TECHNOTICSROBOTICS/avr-nrf/hardware/avr-nrf.brd

## EAGLE design hardware/avr-nrf.brd (2012-05-06)

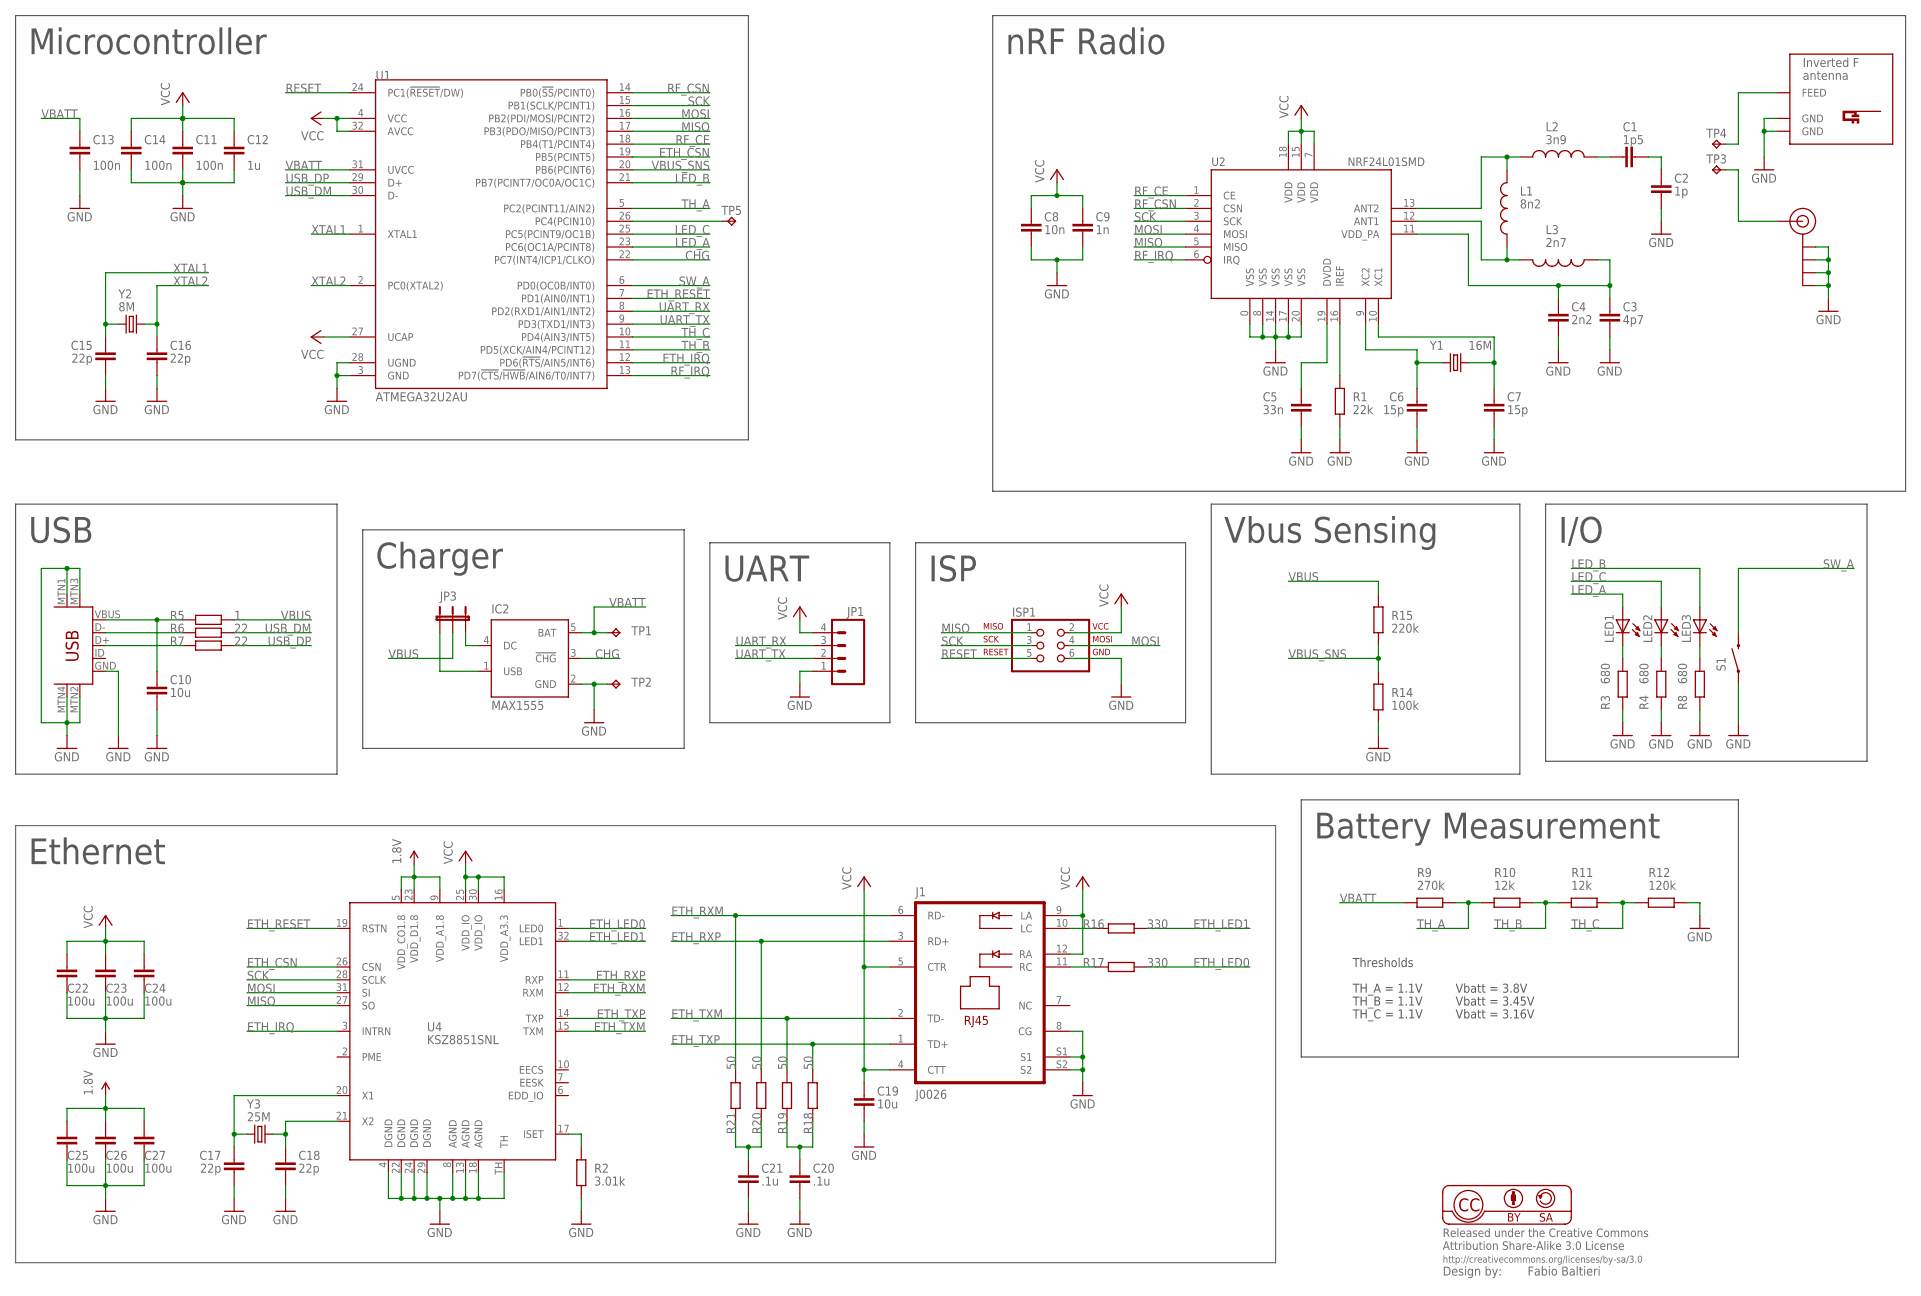
[picture p1: schematic avr-nrf.sch]

Parts:
C1: 1p5; C0805
C2: 1p; C0805
C3: 4p7; C0805
C4: 2n2; C0805
C5: 33n; C0805
C6, C7: 15p; C0805
C8: 10n; C0805
C9: 1n; C0805
C10, C19: 10u; C0805
C11, C13, C14: 100n; C0805
C12: 1u; C0805
C15, C16, C17, C18: 22p; C0805
C20, C21: .1u; C0805
C22, C23, C24, C25, C26, C27: 100u; C0805
IC2: MAX1555; SOT23-5L
ISP1: ISP-AVR910PTH; 2X03
J1: J0026; PJ-J0
J$1: SMA_EDGE; SMA-EDGE
JP1: M04PTH; 1X04
JP3: JUMPER-3SMD; SJ_3
L1: 8n2; 0603
L2: 3n9; 0603
L3: 2n7; 0603
LED1, LED2, LED3: LEDCHIPLED_0805; CHIPLED_0805
R1: 22k; R0603
R2: 3.01k; R0603
R3, R4, R8: 680; R0603
R5: 1; R0603
R6, R7: 22; R0603
R9: 270k; R0603
R10, R11: 12k; R0603
R12: 120k; R0603
R14: 100k; R0603
R15: 220k; R0603
R16, R17: 330; R0603
R18, R19, R20, R21: 50; R0603
S1: SWITCH-MOMENTARY-2SMD; TACTILE_SWITCH_SMD
TP1, TP2: TPTP12R; TP12R
TP3, TP4: TPTP08SQ; TP08SQ
TP5: TPTP06R; TP06R
U1: ATMEGA32U2AU; TQFP32-08
U2: NRF24L01SMD; QFN20
U3: USB-MINIB-5PIN; USB-MINIB
U4: KSZ8851SNL; MLF32-TH
U$1: INVERTED_F_ANTENNA+5; DN007+5
Y1: 16M; CRYSTAL-SMD-5X3
Y2: 8M; CRYSTAL-SMD-5X3
Y3: 25M; CRYSTAL-SMD-5X3

Connections:
1.8V: C25.1, C26.1, C27.1, U4.5 (VDD_CO1.8), U4.9 (VDD_A1.8), U4.23 (VDD_D1.8)
CHG: IC2.3 (!CHG), U1.22 (PC7(INT4/ICP1/CLKO))
ETH_CSN: U1.19 (PB5(PCINT5)), U4.26 (CSN)
ETH_IRQ: U1.12 (PD6(!RTS!/AIN5/INT6)), U4.3 (INTRN)
ETH_LED0: R17.2, U4.1 (LED0)
ETH_LED1: R16.2, U4.32 (LED1)
ETH_RESET: U1.7 (PD1(AIN0/INT1)), U4.19 (RSTN)
ETH_RXM: J1.6 (RD-), R21.2, U4.12 (RXM)
ETH_RXP: J1.3 (RD+), R20.2, U4.11 (RXP)
ETH_TXM: J1.2 (TD-), R19.2, U4.15 (TXM)
ETH_TXP: J1.1 (TD+), R18.2, U4.14 (TXP)
GND: C2.2, C3.2, C4.2, C5.2, C6.2, C7.2, C8.2, C9.2, C10.2, C11.2, C12.2, C13.2, C14.2, C15.2, C16.2, C17.2, C18.2, C19.2, C20.2, C21.2, C22.2, C23.2, C24.2, C25.2, C26.2, C27.2, IC2.2 (GND), ISP1.6, J1.8 (CG), J1.S1, J1.S2, J$1.GND@0 (GND), J$1.GND@1 (GND), J$1.GND@2 (GND), J$1.GND@3 (GND), JP1.1, R1.2, R2.2, R3.2, R4.2, R8.2, R12.1, R14.2, S1.1, TP2.TP, U1.3 (GND), U1.28 (UGND), U2.0 (VSS), U2.8 (VSS), U2.14 (VSS), U2.17 (VSS), U2.20 (VSS), U3.GND, U3.MTN1 (MTN2), U3.MTN2 (MTN3), U3.MTN3 (MTN1), U3.MTN4, U4.4 (DGND), U4.8 (AGND), U4.13 (AGND), U4.18 (AGND), U4.22 (DGND), U4.24 (DGND), U4.29 (DGND), U4.TH, U$1.GND, U$1.GND@1 (GND)
LED_A: LED1.A, U1.23 (PC6(OC1A/PCINT8))
LED_B: LED3.A, U1.21 (PB7(PCINT7/OC0A/OC1C))
LED_C: LED2.A, U1.25 (PC5(PCINT9/OC1B))
MISO: ISP1.1, U1.17 (PB3(PDO/MISO/PCINT3)), U2.5 (MISO), U4.27 (SO)
MOSI: ISP1.4, U1.16 (PB2(PDI/MOSI/PCINT2)), U2.4 (MOSI), U4.31 (SI)
unnamed: L1.2, L3.2, U2.12 (ANT1)
unnamed: L1.1, L2.1, U2.13 (ANT2)
unnamed: C1.1, L2.2
unnamed: C1.2, C2.1
unnamed: C3.1, C4.1, L3.1, U2.11 (VDD_PA)
unnamed: J$1.SIG (SIGNAL), TP3.TP
unnamed: C5.1, U2.19 (DVDD)
unnamed: R1.1, U2.16 (IREF)
unnamed: C7.1, U2.10 (XC1), Y1.3 (2)
unnamed: C6.1, U2.9 (XC2), Y1.1
unnamed: TP4.TP, U$1.FEED
unnamed: IC2.4 (DC), JP3.3
unnamed: R7.1, U3.D+
unnamed: R6.1, U3.D-
unnamed: LED1.C, R3.1
unnamed: IC2.1 (USB), JP3.1
unnamed: LED2.C, R4.1
unnamed: LED3.C, R8.1
unnamed: J1.10 (LC), R16.1
unnamed: J1.11 (RC), R17.1
unnamed: R2.1, U4.17 (ISET)
unnamed: C17.1, U4.20 (X1), Y3.1
unnamed: C18.1, U4.21 (X2), Y3.3 (2)
unnamed: TP5.TP, U1.26 (PC4(PCIN10))
unnamed: C21.1, R20.1, R21.1
unnamed: C20.1, R18.1, R19.1
unnamed: C10.1, R5.1, U3.VBUS
RESET: ISP1.5, U1.24 (PC1(!RESET!/DW))
RF_CE: U1.18 (PB4(T1/PCINT4)), U2.1 (CE)
RF_CSN: U1.14 (PB0(!SS!/PCINT0)), U2.2 (CSN)
RF_IRQ: U1.13 (PD7(!CTS!/!HWB!/AIN6/T0/INT7)), U2.6 (IRQ)
SCK: ISP1.3, U1.15 (PB1(SCLK/PCINT1)), U2.3 (SCK), U4.28 (SCLK)
SW_A: S1.3 (2), U1.6 (PD0(OC0B/INT0))
TH_A: R9.1, R10.2, U1.5 (PC2(PCINT11/AIN2))
TH_B: R10.1, R11.2, U1.11 (PD5(XCK/AIN4/PCINT12))
TH_C: R11.1, R12.2, U1.10 (PD4(AIN3/INT5))
UART_RX: JP1.3, U1.8 (PD2(RXD1/AIN1/INT2))
UART_TX: JP1.2, U1.9 (PD3(TXD1/INT3))
USB_DM: R6.2, U1.30 (D-)
USB_DP: R7.2, U1.29 (D+)
VBATT: C13.1, IC2.5 (BAT), R9.2, TP1.TP, U1.31 (UVCC)
VBUS: JP3.2, R5.2, R15.1
VBUS_SNS: R14.1, R15.2, U1.20 (PB6(PCINT6))
VCC: C8.1, C9.1, C11.1, C12.1, C14.1, C19.1, C22.1, C23.1, C24.1, ISP1.2, J1.4 (CTT), J1.5 (CTR), J1.9 (LA), J1.12 (RA), JP1.4, U1.4 (VCC), U1.27 (UCAP), U1.32 (AVCC), U2.7 (VDD), U2.15 (VDD), U2.18 (VDD), U4.16 (VDD_A3.3), U4.25 (VDD_IO), U4.30 (VDD_IO)
XTAL1: C15.1, U1.1 (XTAL1), Y2.1
XTAL2: C16.1, U1.2 (PC0(XTAL2)), Y2.3 (2)

Notes on the sheet:
USB
UART
Microcontroller
ISP
Charger
nRF Radio
I/O
Battery Measurement
Vbus Sensing
Ethernet
Thresholds
TH_A = 1.1V
TH_C = 1.1V
TH_B = 1.1V
Vbatt = 3.8V
Vbatt = 3.45V
Vbatt = 3.16V

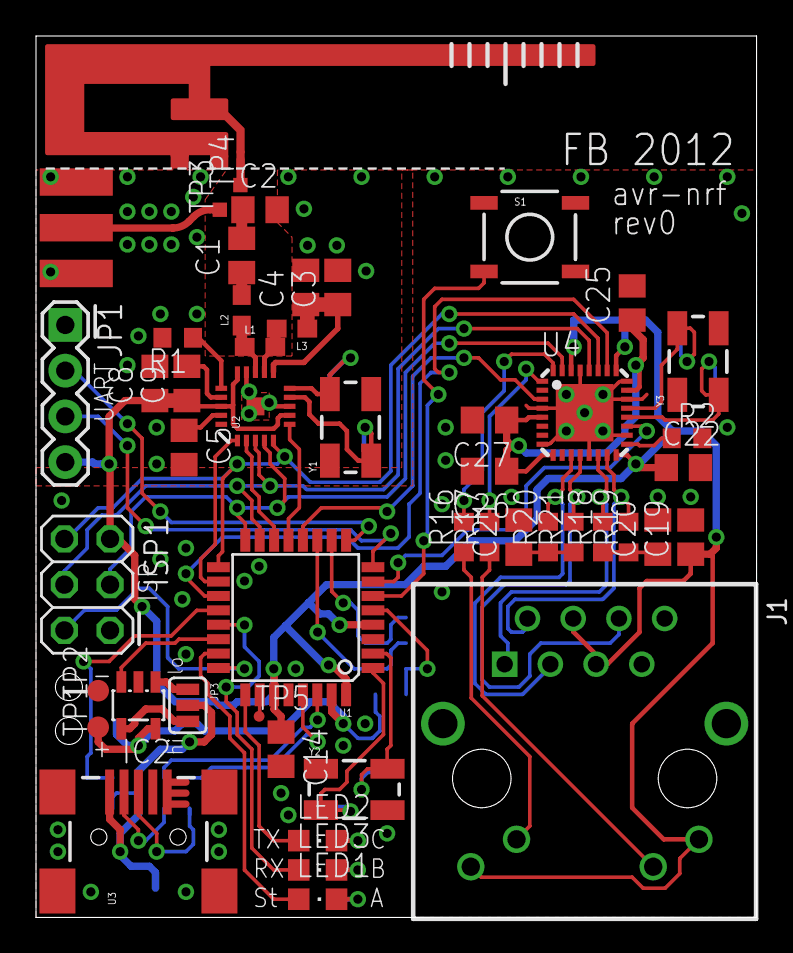
[picture p2: board avr-nrf.brd from above]

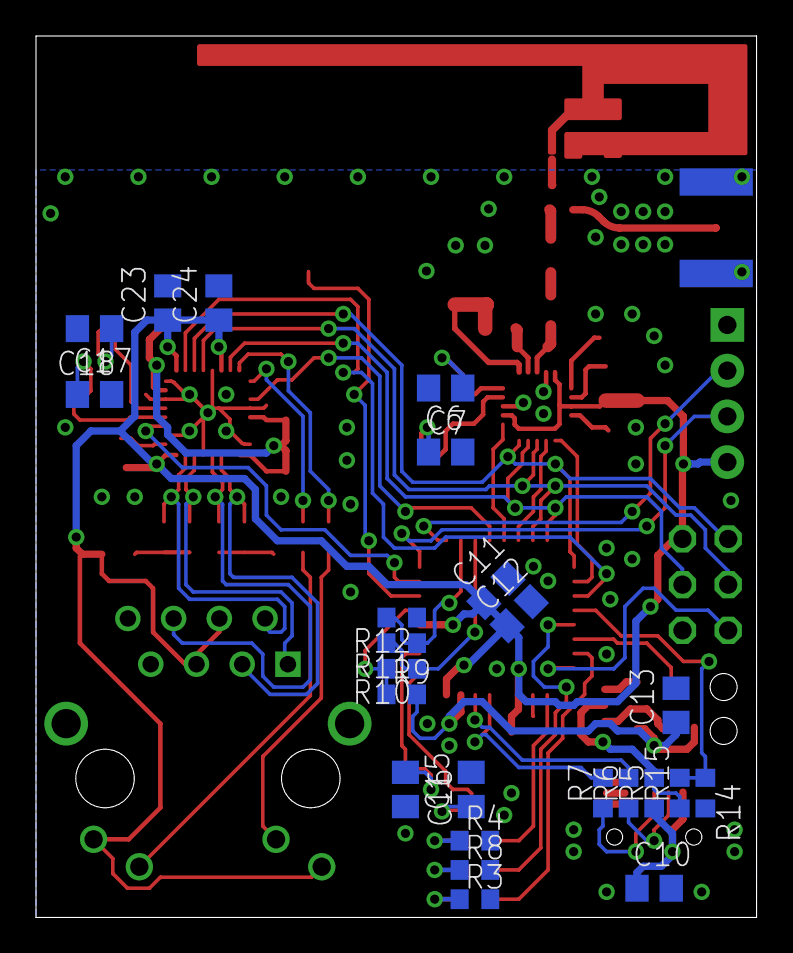
[picture p3: board avr-nrf.brd from below]

Board: 2 copper layers, 40.0 x 49.0 mm, 73 parts (24 on the bottom side), 63 nets.
