TECHNOTICSROBOTICS/avr-nrf/firmware/fifo.c

/*
 * Copyright 2012 Fabio Baltieri <fabio.baltieri@gmail.com>
 *
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
 */

#include <stdio.h>

#include "fifo.h"

struct fifo rf_tx_fifo;
struct fifo rf_rx_fifo;

uint8_t *fifo_get_head(struct fifo *fifo)
{
	if (fifo->count < FIFO_SIZE)
		return fifo->entry[fifo->head].data;
	else
		return NULL;
}

void fifo_push(struct fifo *fifo)
{
	fifo->head = (fifo->head + 1) % FIFO_SIZE;
	fifo->count++;
}

uint8_t *fifo_get_tail(struct fifo *fifo)
{
	if (fifo->count)
		return fifo->entry[fifo->tail].data;
	else
		return NULL;
}

void fifo_pop(struct fifo *fifo)
{
	fifo->tail = (fifo->tail + 1) % FIFO_SIZE;
	fifo->count--;
}

uint8_t fifo_full(struct fifo *fifo)
{
	return (fifo->count >= FIFO_SIZE);
}

uint8_t fifo_count(struct fifo *fifo)
{
	return fifo->count;
}

void fifo_clear(struct fifo *fifo)
{
	fifo->head = 0;
	fifo->tail = 0;
	fifo->count = 0;
}
