TECHNOTICSROBOTICS/avr-nrf/firmware/uart.c

/*
 * Copyright 2011 Fabio Baltieri (fabio.baltieri@gmail.com)
 *
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
 */

#include "defines.h"

#include <avr/io.h>
#include <avr/interrupt.h>
#include <stdio.h>

#include "uart.h"

#define BAUD UART_SPEED
#include <util/setbaud.h>

#if defined (__AVR_ATmega32U2__)
#define UBRRL UBRR1L
#define UBRRH UBRR1H
#define RXEN RXEN1
#define TXEN TXEN1
#define UCSRA UCSR1A
#define UCSRB UCSR1B
#define RXC RXC1
#define UDRE UDRE1
#define UDR UDR1
#define U2X U2X1
#endif

FILE uart_stdout = FDEV_SETUP_STREAM((int (*)(char, FILE *))uart_putchar,
				     (int (*)(FILE *))uart_getchar,
				     _FDEV_SETUP_RW);

/* uart */

void uart_init(void)
{
	UBRRL = UBRRL_VALUE;
	UBRRH = UBRRH_VALUE;
	UCSRB = _BV(RXEN) | _BV(TXEN);
#if USE_2X
	UCSRA |= _BV(U2X);
#else
	UCSRA &= ~_BV(U2X);
#endif
}

int uart_poll(void)
{
	if (UCSRA & _BV(RXC))
		return 1;
	else
		return 0;
}

int uart_putchar(char ch)
{
	if (ch == '\n')
		uart_putchar('\r');
	loop_until_bit_is_set(UCSRA, UDRE);
	UDR = ch;
	return ch;
}

int uart_getchar(void)
{
	while (!(UCSRA & _BV(RXC)));
	return UDR;
}

int uart_puts(char *s)
{
	while (*s) {
		uart_putchar(*s++);
	}
	return 0;
}
