TECHNOTICSROBOTICS/avr-nrf/firmware/blink.c

/*
 * Copyright 2011 Fabio Baltieri <fabio.baltieri@gmail.com>
 *
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
 */

#include "defines.h"

#include <avr/io.h>
#include <avr/interrupt.h>

#include "blink.h"
#include "suspend.h"

volatile uint16_t jiffies;

static volatile uint8_t led_timeout_a;
static volatile uint8_t led_timeout_b;
static volatile uint8_t led_timeout_c;

void blink_init(void)
{
	TIMSK0 = ( (1 << OCIE0A) );

	TCCR0A = ( (1 << WGM01) | (0 << WGM00) ); /* CTC */
	TCCR0B = ( (0 << WGM02) |
		   (1 << CS02) | (0 << CS01) | (1 << CS00) ); /* /1024 */

	OCR0A = F_CPU / 1024 / HZ; /* about 200Hz */

	led_timeout_a = 0;
	led_timeout_b = 0;
	led_timeout_c = 0;
	suspend_enable(SLEEP_TIMER0);
}

ISR(TIMER0_COMPA_vect)
{
	if (led_timeout_a)
		if (!--led_timeout_a)
			led_a_off();
	if (led_timeout_b)
		if (!--led_timeout_b)
			led_b_off();
	if (led_timeout_c)
		if (!--led_timeout_c)
			led_c_off();

	if (!led_timeout_a && !led_timeout_b && !led_timeout_c )
		suspend_enable(SLEEP_TIMER0);

	jiffies++;
}

void blink_a(void)
{
	led_a_on();
	led_timeout_a = 2;
	suspend_disable(SLEEP_TIMER0);
}

void blink_c(void)
{
	led_c_on();
	led_timeout_c = 2;
	suspend_disable(SLEEP_TIMER0);
}

void blink_b(void)
{
	led_b_on();
	led_timeout_b = 2;
	suspend_disable(SLEEP_TIMER0);
}
