TECHNOTICSROBOTICS/avr-nrf/(commit log)

2011-12-04 hardware: initial schematics and brd import
    [avr-nrf.brd, avr-nrf.sch]
2011-12-04 add battery calculator utility
2011-12-04 hardware: add antenna library
2011-12-04 hardware: updated layout
    [avr-nrf.brd, avr-nrf.sch]
2011-12-05 hardware: implemented stefano's notes
    [avr-nrf.brd, avr-nrf.sch]
2011-12-05 hardware: layout improvements
    [avr-nrf.brd, avr-nrf.sch]
2011-12-05 hardware: minor layout updates
    [avr-nrf.brd]
2011-12-05 hardware: other layout improvements
    [avr-nrf.brd]
2011-12-05 hardware: last update for today
    [avr-nrf.brd]
2011-12-11 hardware: change qfn pads shape to pass DRC
    [avr-nrf.brd, avr-nrf.sch]
2011-12-11 hardware: redraw antenna to pass DRC tests
    [avr-nrf.brd, avr-nrf.sch]
2011-12-11 hardware: add silkscreen
    [avr-nrf.brd, avr-nrf.sch]
2011-12-15 hardware: modify rf gnd layout, add border vias
    [avr-nrf.brd]
2011-12-26 hardware: convert to eagle 6 format (xml)
    [avr-nrf.brd, avr-nrf.sch]
2012-04-02 hardware: fix eth cap values
    [avr-nrf.brd, avr-nrf.sch]
2012-04-02 firmware: move cs init from drivers to main
2012-04-02 firmware: add preliminary ksz8851snl driver
2012-05-04 firmware: add charging indicator
2012-05-05 hw: antenna: add pre-cut variants
2012-05-05 hw: update antenna symbol on schematics
    [avr-nrf.brd, avr-nrf.sch]
2012-05-06 hw: add no-eth variant
    [avr-nrf.brd, avr-nrf.sch]
2012-05-06 fw: add power_down code
2012-05-08 fw: fix vendor id mispell
    [descr.c]
2012-05-09 fw: nrf: change channel to 24 (less wifi-g interferences)
    [nrf24l01p.c]
2012-05-09 Revert "fw: add power_down code"
    This reverts commit 23964ade6c0fe154e3c36222626aa786d36f36f9.
    [blink.c, defines.h, main.c]
2012-05-09 fw: move led blink in wdt isr
2012-05-10 fw: board: rewrite reset function
    [board.c]
2012-05-10 fw: main: enable power down mode
2012-05-10 fw: blink: rework blink code
    [blink.c, blink.h]
2012-05-10 fw: main: add button suspend check
2012-05-13 fw: add missing gpl headers
    [fifo.c, ksz8851snl.c, suspend.c]
2012-05-13 fw: add fifo_full, fix Makefile
    [fifo.c, fifo.h, nrf24l01p.c]
2012-05-13 fw: main: missing blank
    [main.c]
2012-05-13 main: missing static identifier from hello
    [main.c]
2012-05-13 fw: implement power control
    Turn RX off when running without usb connectivity
2012-05-13 fw: add board id functions
2012-05-13 scripts: add board-id
2012-05-14 fw: nrf: powerdown only when necessary
2012-11-10 decode: add vbatt charging print
2012-11-13 fw: fix button init
    [defines.h]
2012-11-15 fw: main: init button
2012-11-15 fw: add missing vital ksz driver functions
    [ksz8851snl.c, ksz8851snl.h]
2012-11-16 fw: ksz881snl: fix read function
    [ksz8851snl.c]
2012-11-25 fw: led: rework led blink code
    [blink.c, blink.h, ksz8851snl.c, main.c, nrf24l01p.c]
2012-11-25 fw: main: disable power down mode
2012-11-25 fw: unbind on button press
2012-11-25 fw: net: relay nrf packets vie network
2012-11-25 fw: nrf: rework bound function
    [base.c]
2012-11-26 decode: add missing net sources
    [net.c, net.h]
2012-11-29 fw: net: missed a blank line
    [base.c]
2013-12-25 decode: decode boot frames
