TECHNOTICSROBOTICS/avr-nrf/(notices)

Notices in the files:
firmware/fifo.c:
it under the terms of the GNU General Public License as published by
the Free Software Foundation, either version 3 of the License, or
(at your option) any later version.
parts and their libraries:
balto: Released under the Creative Commons
balto: http://creativecommons.org/licenses/by-sa/3.0
